farmerkeith/WiFiMiniSolarCharger/schematicV2/MOSFET P-channel IRF9540.jpg

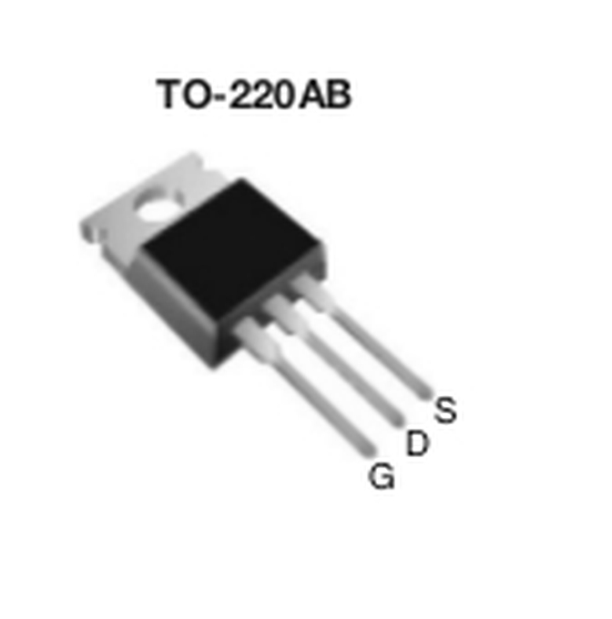
schematicV2/MOSFET P-channel IRF9540.jpg
