farmerkeith/WiFiMiniSolarCharger/schematicV2/NPN 2N3904.jpg

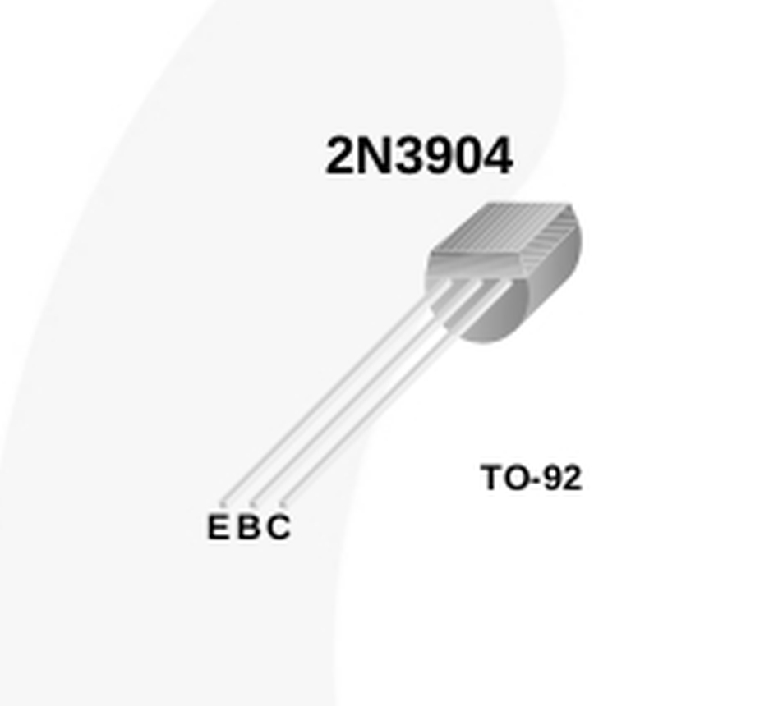
schematicV2/NPN 2N3904.jpg
