farmerkeith/WiFiMiniSolarCharger/schematicV2/WiFiMiniSolarChargerV2BOM.ods

Sheet: WiFiMiniSolarChargerV2BOM
Reference | Value | Footprint | Pins | Extras | Total
U2 | WeMosD1MiniPro | Module | 16 | 7 | 23
U1 | MP2307_DC-DCconvertermodule | Module | 14 | 14 | 28
J1 | Solar panel 12-20V | Terminal | 2 | 6 | 8
J2 | Battery 12V | Terminal | 2 | 6 | 8
R4 | 1.2M | resistor | 2 | 0 | 2
Q2 | IRF4905 | TO-220 | 3 | 3 | 6
R3 | 82K | resistor | 2 | 0 | 2
Q4 | 2N3904 | NPN | 3 | 0 | 3
C1 | 100nF | Capacitor | 2 | 0 | 2
D1 | TVS P6KE47CA | Diode | 2 | 0 | 2
Q1 | IRF4905 | TO-220 | 3 | 3 | 6
R1 | 1M | resistor | 2 | 0 | 2
R5 | 10K | resistor | 2 | 0 | 2
D2 | 1N5817 | Diode | 2 | 0 | 2
Q3 | 2N3904 | NPN | 3 | 0 | 3
R2 | 10K | resistor | 2 | 0 | 2
D3 | 1N5817 | Diode | 2 | 0 | 2
U4 | DS18B20 | Sensor | 3 | 0 | 3
U3 | DS18B20 | off circuit | 0 |  | 0
J3 | Conn_01x03_Female | Sensor | 3 | 0 | 3
J4 | Conn_01x03_Male | off circuit | 0 |  | 0
Total |  |  |  |  | 109
Board size
Width |  |  | 10
Length |  |  | 13
Area |  |  | 130
Parts count | On board
 | Terminal | 2
 | Module | 1
 | Resistor | 5
 | MOSFET | 2
 | 2N3904 | 2
 | TVS | 1
 | Capacitor | 1
 | Diode | 2
 | Header F | 1
 | DS18B20 | 1
 | On board Total | 18
 | Off board
 | Header M | 1
 | DS18B20 | 1
 | WeMos D1 mini pro | 1
 | Off board Total | 3
 | Total | 21

Sheet: Layout
Circuit board layout |  |  |  | USB / Screw terminal end
Column | 1 | 2 | 3 | 4 | 5 | 6 | 7 | 8 | 9 | 10
Row
1 |  | Battery screw terminal |  |  |  | Solar panel screw terminal
2 |  | Gnd |  | +Vbb |  | Gnd |  | +Vpp
3 | 5V |  | D2 | D2 |  | D1 TVS |  | D1 TVS |  | 3V3 | Wemos
4 | GND |  | D3 | D3 | B Q3 | R2 | G Q1 |  | R3 | D8 | IRF4905
5 | D4 |  | C Q4 | E Q3 |  | C Q3 | R1 | D Q1 | R3 | D7 | 2N3904
6 | D3 |  |  | G Q2 | D Q2 | S Q2 | R1 | S Q1 |  | D6
7 | D2 R5 | B Q4 | E Q4 |  |  |  |  |  |  | D5
8 | D1 |  |  | H 1 | H2 | H3 | H4 |  |  | D0
9 | Rx |  |  | DS1 | DS2 | DS3 |  | R4 | R4 | A0
10 | Tx | +4V |  |  |  |  |  | +12V |  | RST
11 |  |  | DC-DC buck converter |  |  |  |  |  | C1
12 |  |  |  |  |  |  |  |  | C1
13 |  | GND |  |  |  |  |  | GND

Sheet: Breadboard
Terminal | 2 | Battery screw terminal J1 | Battery screw terminal J2 | Battery screw terminal J2 |  |  | Done
Module | 1 | DC-DC buck converter U1 |  |  |  |  | Done
Resistor | 5 | R1 | R2 | R3 | R4 | R5
MOSFET | 2 | Q1 | Q2 |  |  |  | Done
2N3904 | 2 | Q3 | Q4 |  |  |  | Done
TVS | 1 | D1 TVS |  |  |  |  | Done
Capacitor | 1 | C1 |  |  |  |  | Done
Diode | 2 | D2 | D3 |  |  |  | Done
DS18B20 | 1 | DS U3 | DSU4 |  |  |  | Done
WeMos D1 mini pro | 1 |  | U2
Bradboard Row
 | Column | A | B | C | D | E |  | F | G | H | I | J
61
60
59 |  |  | Wemos |  | 5V |  |  |  | 3V3 |  | Wemos |  | 3V3
58 |  |  | Wemos |  | GND |  |  |  | D8 |  | Wemos
57 |  |  | Wemos |  | D4 |  |  |  | D7 |  | Wemos
56 |  |  | Wemos |  | D3 |  |  |  | D6 |  | Wemos
55 |  |  | Wemos |  | D2 |  |  |  | D5 |  | Wemos
54 |  |  | Wemos |  | D1 |  |  |  | D0 |  | Wemos
53 |  |  | Wemos |  | Rx |  |  |  | A0 |  | Wemos
52 |  |  | Wemos |  | Tx |  |  |  | RST |  | Wemos
51
50 |  | J2 Vbb+
49
48 | GND | J2 Vbb-
47
46 |  | J1 Vpp+ |  |  |  | D1 TVS
45
44 | GND | J2 Vpp- |  |  |  | D1 TVS
43
42 |  |  |  | +5 |  |  |  |  | +12 | R4
41 |  |  |  |  |  |  |  |  |  | R4 |  | C1
40
39 | GND |  |  | GND |  |  |  |  | GND |  |  | C1
38 |  | R3
37 |  |  |  | Q1 G |  | R1
36 |  | R3 |  | Q1 D
35 |  |  |  | Q1 S |  | R1
34
33 |  |  |  | Q2 S
32 |  |  |  | Q2 D
31 |  |  |  | Q2 G
30
29 |  |  |  | Q3 C |  | R2
28 |  |  |  | Q3 B |  | R2
27 |  |  |  | Q3 E
26 |  | R5 |  |  |  |  |  |  |  | D2 A
25 |  |  |  | Q4 C |  |  |  |  | D3 K | D2 K
24 |  | R5 |  | Q4 B |  |  |  |  | D3 A
23 | GND |  |  | Q4 E
22
21 | GND |  |  | DS U3 | DSU4 | 1
20 |  |  |  | DS U3 | DSU4 | 2
19 |  |  |  | DS U3 | DSU4 | 3 |  |  |  |  |  |  | 3V3
18
17
16
15
14
13
12
11
10
9
8
7
6
5
4
3
2
1
0
-1
-2
