farmerkeith/WiFiMiniSolarCharger/flowChart/chargerFlowChartOnOff.pdf

## WiFiMiniSolarCharger charger logic flow chart

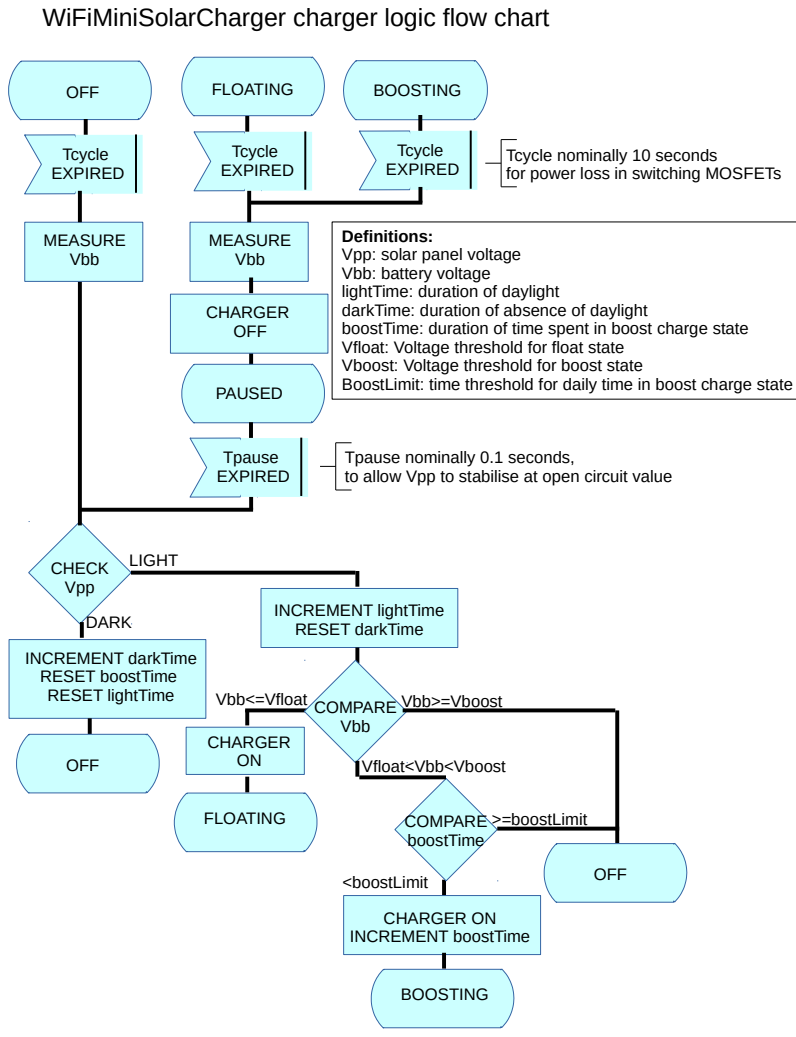
[picture p3: page 1]
FLOATING; Tcycle EXPIRED; MEASURE Vbb; CHECK Vpp; BOOSTING; CHARGER OFF; PAUSED; OFF; Tpause EXPIRED; INCREMENT darkTime RESET boostTime RESET lightTime; DARK; LIGHT; INCREMENT lightTime RESET darkTime; COMPARE Vbb; Vbb<=Vfloat; CHARGER ON; Vbb>=Vboost; COMPARE boostTime; >=boostLimit; <boostLimit; CHARGER ON INCREMENT boostTime

Tcycle nominally 10 seconds
for power loss in switching MOSFETs

Definitions:
Vpp: solar panel voltage
Vbb: battery voltage
lightTime: duration of daylight
darkTime: duration of absence of daylight
boostTime: duration of time spent in boost charge state
Vfloat: Voltage threshold for float state
Vboost: Voltage threshold for boost state
BoostLimit: time threshold for daily time in boost charge state

Tpause nominally 0.1 seconds,
to allow Vpp to stabilise at open circuit value

Vfloat<Vbb<Vboost
