farmerkeith/WiFiMiniSolarCharger/schematicV2/WiFiMiniSolarChargerV2.pdf

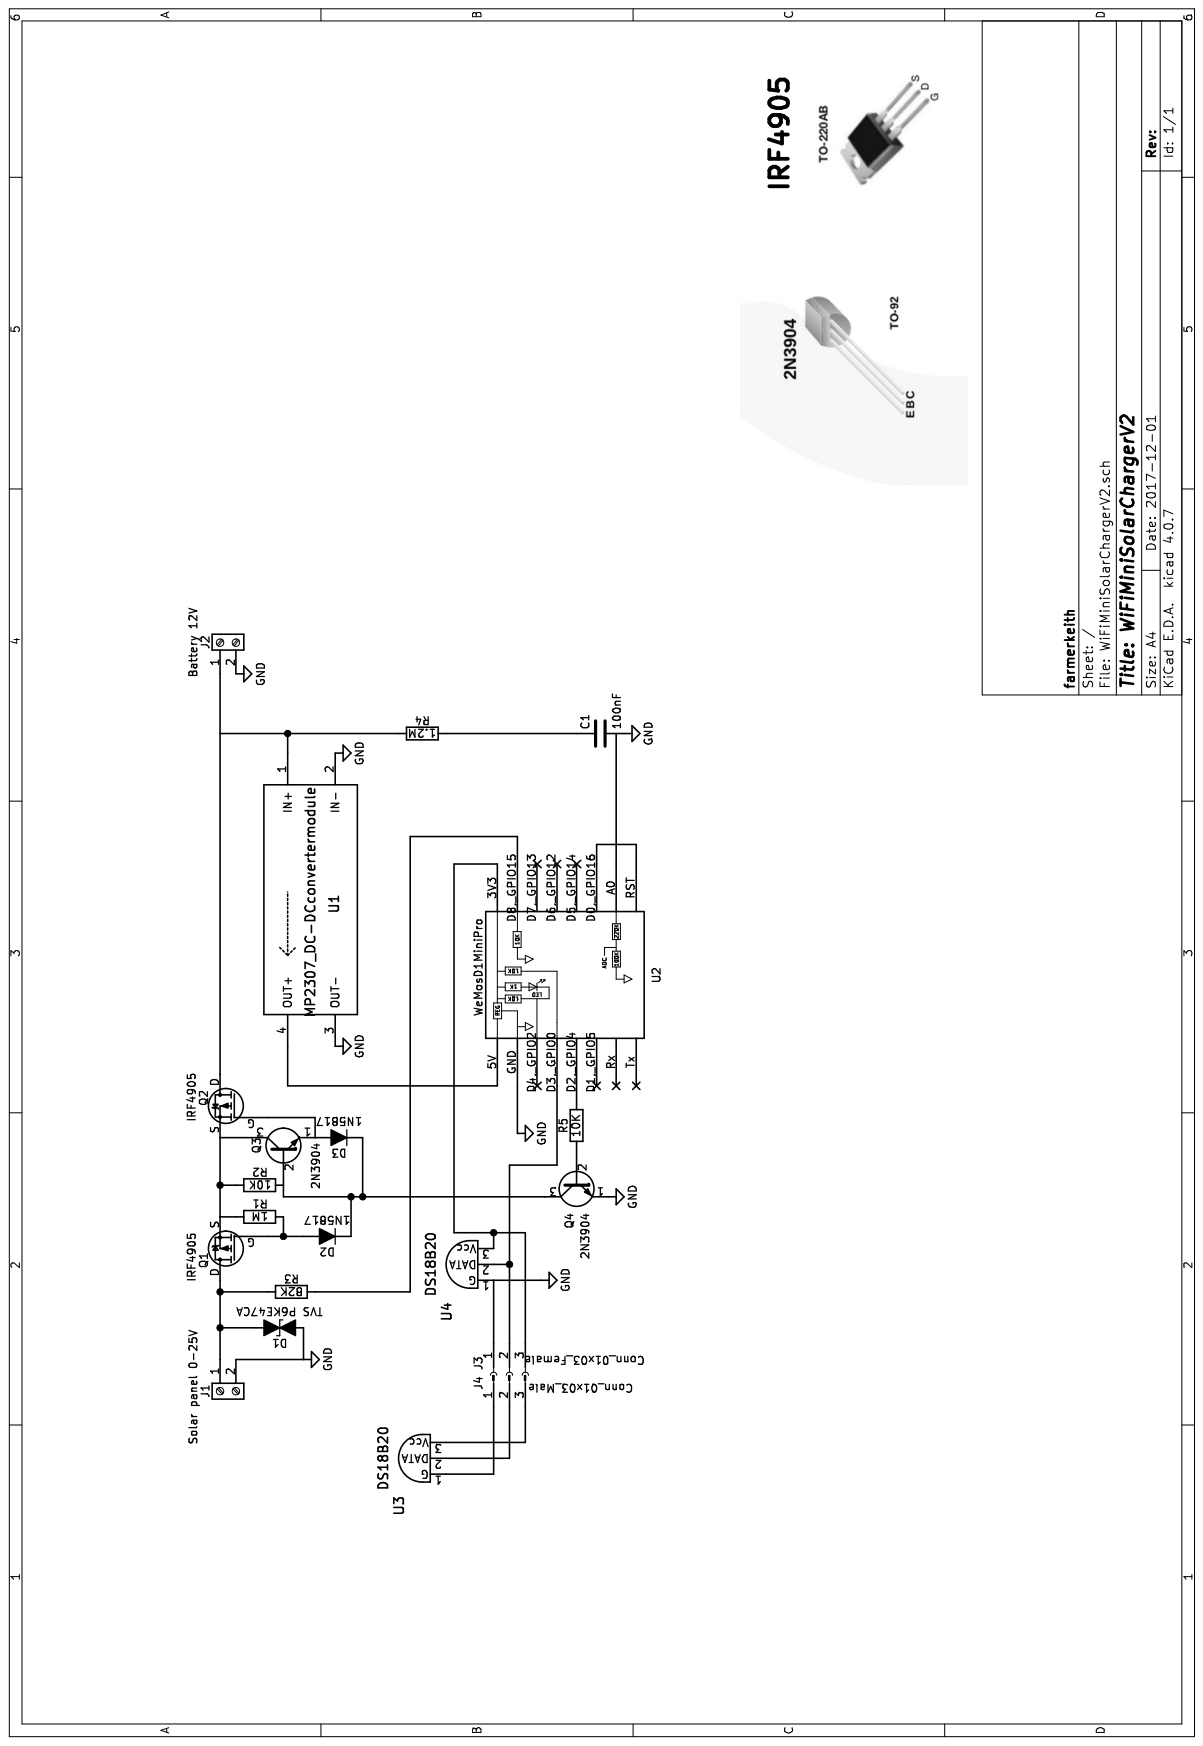
[picture p4: page 1]
