farmerkeith/WiFiMiniSolarCharger/schematic/WiFiMiniSolarCharger.pdf

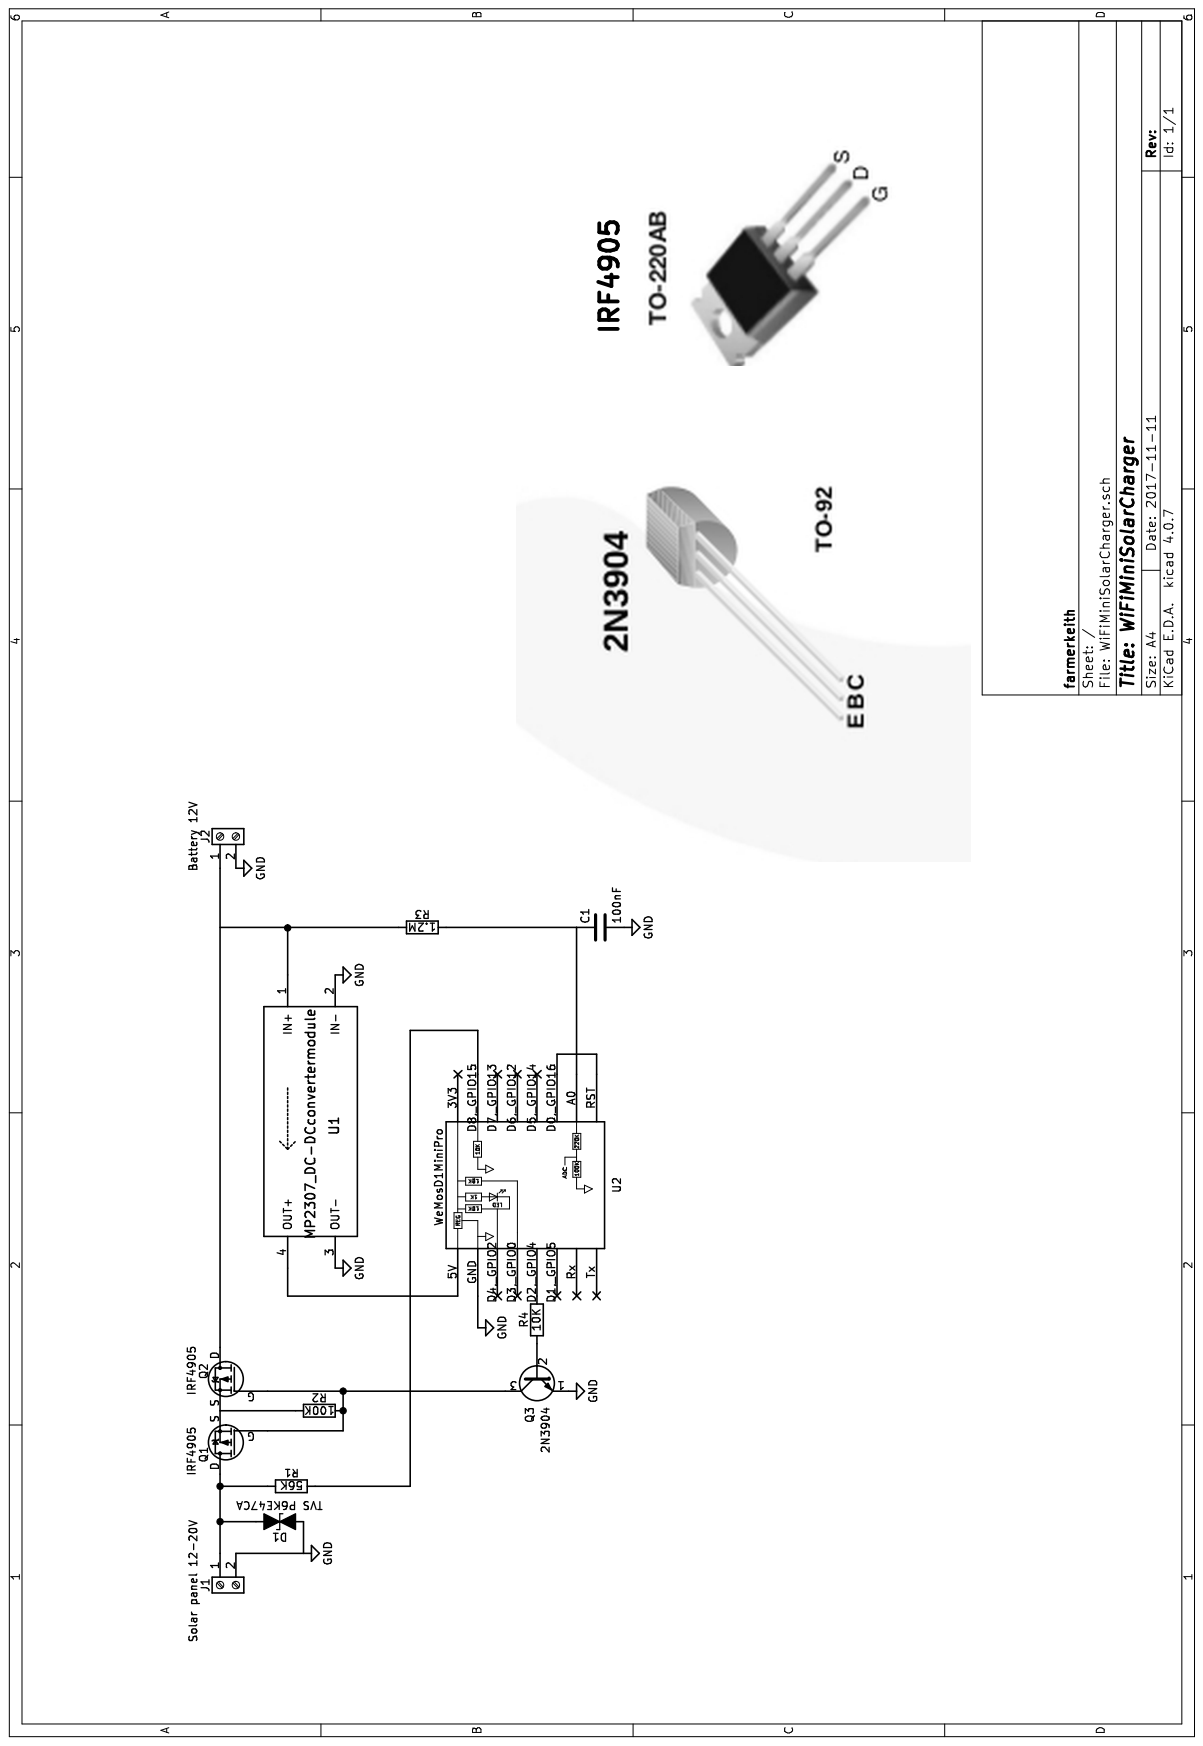
[picture p5: page 1]
