farmerkeith/WiFiMiniSolarCharger/(commit log)

2017-12-02 changed structure. Added schematicV2
    [MOSFETDriver.sch, WiFiMiniSolarCharger.kicad_pcb, WiFiMiniSolarCharger.sch, WiFiMiniSolarChargerV2.kicad_pcb, WiFiMiniSolarChargerV2.sch]
2017-12-07 updates to support PWM
    [WiFiMiniSolarChargerV2.sch, WiFiMiniSolarChargerV2BOM.csv, WiFiMiniSolarChargerV2BOM.ods]
